hotchk155/pokey-synth/docs/idea.odt

PokeyPig

Introduction

PokeyPig is a MIDI-controlled digital synthesizer based around the Atari CO12294 “POKEY” chip. The POKEY was the sound chip behind Atari home computers in the 1980's and found itself used in a whole bunch or Atari arcade games. POKEY has a distinctive sound – its four channels of warm chimey square wave goodness were often not quite in tune (due to the limitations of the pitch resolution) but nobody cared – it sounded good - and three decades later it still does!

PokeyPig is not the first MIDI synthesizer to use POKEY chips for music, but I hope it is one of the most fun to use. I've tried to make it easy to use while still allowing a whole lot of flexibility so you can keep going deeper with it and probably come up with stuff I never even thought of. The code is also all open-source and based around the popular Arduino toolchain, so you can even get your hands dirty in the firmware coding and tweak it or even rewrite it. Whatever you do with it, I'd love to see it!

The Synth

POKEYpig supports either a single or dual POKEY's.

Each POKEY chip natively supports

- Four square wave voices with 8-bit frequency dividers and digital distortion
- Ability to pair two 8-bit voices into a single channel with 16-bit frequency division (up to two 16 bit voices per POKEY). This can be done to improve the range and the pitch accuracy of the channels.
- Ability to pair two 8-bit voices to provide a single 8 bit voice with digital high-pass filter.
- Master “high” or “low” range for all 8-bit voices on a given POKEY.

PokeyPig gives you access to all the native POKEY chip features, while adding a wealth of functions of its own, such as:

- Amp and Modulation Envelopes
- Low Frequency Oscillator (LFO)
- A flexible modulation matrix
- Pitch Bend
- Portamento
- Polyphonic mode or Unison with Detune and Arpeggiation

Synth configurations (or “tones”) can be saved to EEPROM storage and instantly recalled later.

If you have dual POKEY chips in your PokeyPig you have the additional possibilities of

- Doubling the number of voices available to a Tone, giving you more polyphony or thicker unison sounds.

Or

- Running two tones at the same time, on different MIDI channels (each tone is limited to the voices on a single POKEY chip)

Some Terminology

I even confuse myself with not being consistent in my terminology, so lets set some ground rules now so we know where we stand:

- Lets use the word “tone” to refer to a particular setup of PokeyPig – like a specific type of sound you're getting out of it . For example “crunchy detuned bass sound” or “brassy sound” are “tones”. Tones can be saved to PokeyPigs EEPROM and recalled later.
- Lets use the word “voice” to refer to a single musical note played by PokeyPig. So, to play a chord will requires multiple voices because each voice can only play one note at a time. Typically you'll have two, four or eight voices available depending how many POKEY chips you have and how your tone is configured.
- Lets use the word “channel” to refer to the set of voices that are all assigned to the same tone, allowing polyphony or unison layering. A PokeyPig channel will generally correspond to a given MIDI input channel.
  If you have a single POKEY chip, PokeyPig supports just a single channel, playing a single tone using two or four voices.
  If you have two POKEY chips, you have four or eight voices in a single channel, or you can run two channels side by side, each with two or four voices, each playing different tones (or even the same tone if you like)

Envelopes

Each tone has both an amp and modulation envelope

- The amp envelope controls how the volume of each voice changes over time after a note is played. For example you can change the amp envelope settings to emulate the way an organ note starts immediately as a key is pressed and stops instantly as it is released, or the way a piano note rings and fades slowly after it is struck, or a sax note “swells”
- The modulation envelope works in exactly the same as the amp envelope, but rather than controlling the volume of a note, you can use it to control other properties of the sound of the note, such as pitch or distortion. For example you could have a sound which brings in more nasty distortion the longer the note is held.

Each envelope has an attack and a decay/release control and can operate in one of the following modes

- “Attack-Release” mode is the default. When a key is pressed, the envelope runs up to its highest level at the attack rate, then “sustains” at that highest level until the key is released, at which point it fades out according to the release rate.
- In “Attack-Decay” mode, the level runs up to its highest level at the attack rate but then immediately it fades at the release rate (even if the key is still pressed).
- In “Attack-Retrig” mode, the attack slope will immediately start again when the highest level is reached (if the key remains held). As soon as the key is released the envelope will fade at the release rate.
- In “Retrigger” mode, the envelope will function like “Decay” mode, but as soon as the release slope has finished and the volume has faded out, the attack slope will start again (if the key remains held). As soon as the key is released the envelope will begin the release phase.
- In “Loop” mode, the envelope will operate like “Retrigger” mode but will continue to run over and over even after the key is released. This gives you something like an additional LFO to play with (see later) but note that a keypress is needed to start the envelope, and the wave will jump to the start of the attack slope when a key is pressed.

This does open some interesting possibilities, since every voice has its own envelopes (unlike the channel which has just a single LFO). For example if you have 4 note polyphony you could have 4 of these envelope-based LFOs all running out of phase with each other and wreaking glorious havoc with the sound!

Note that POKEY only supports 15 volume levels per voice (plus silent) so the granularity available to amplitude envelope is rather crude and you may hear “volume stepping” on slow attack/release slopes. Nothing I can do about that – sorry!

While the amp evelope always controls the volume of a voice, the modulation envelope can be used to control all kinds of fun things!

Modulation envelope can be used to control

- Pitch – the pitch rises or falls in accordance with the envelope.
- Distortion – the distortion type changes accordance with the envelope.
- High Pass – the high pass filter frequency changes accordance with the envelope (requires channel with high pass filter capability)
- Detune – The detune amount for unison voices is scaled in accordance with the envelope (requires channel in unison mode with a non-zero detune level)
- LFO Rate – The LFO rate is scaled in accordance with the envelope (channel must be in unison mode)
- LFO Level – The LFO amount is scaled in accordance with the envelope (channel must be in unison mode with a non-zero LFO amount)
- Arpeggiator Rate – The rate of the arpeggiator is scaled in accordance with the envelope (requires unison mode and for the arpeggiator to be active)

The modulation envelope effects

Each of the above has a level control which (depending on the modulation destination) specifies a scaling factor of the

Modulation Sources

Mod Envelope
LFO
Mod Wheel

Modulation Destinations

LFO can be sent to pitch with dedicated intensity control

LFO can be sent to volume with dedicated intensity control

LFO can be sent to modulation matrix with adjustable intensity control

Modulation matrix destinations for LFO are

- Distortion
- High Pass Filter
- Detune
- Arpeggiator Rate

Modulation envelope can be sent to modulation matrix with adjustable intensity control

Modulation matrix destinations for mod envelope are

- Pitch
- Distortion
- High Pass Filter
- Detune
- LFO Rate
- LFO Depth (All?)
- Arpeggiator Rate

Modulation wheel can be sent to modulation matrix

- Distortion
- High Pass Filter
- Detune
- LFO Rate
- LFO Depth (All?)
- Arpeggiator Rate

| LFO | Mod Envelope | Mod Wheel
Amplitude | LFO to Amp intensity | N/A | Mod Matrix Flag
Pitch | LFO to Pitch intensity | Mod Envelope to Mod Matrix Intensity x Mod Matrix Flag | N/A
Distortion | LFO to Mod Matrix intensity x Mod Matrix Flag | Mod Envelope to Mod Matrix Intensity x Mod Matrix Flag | Mod Matrix Flag
High Pass | LFO to Mod Matrix intensity x Mod Matrix Flag | Mod Envelope to Mod Matrix Intensity x Mod Matrix Flag | Mod Matrix Flag
Detune | LFO to Mod Matrix intensity x Mod Matrix Flag | Mod Envelope to Mod Matrix Intensity x Mod Matrix Flag | Mod Matrix Flag
LFO Rate | N/A | Mod Envelope to Mod Matrix Intensity x Mod Matrix Flag | Mod Matrix Flag
LFO Depth | N/A | Mod Envelope to Mod Matrix Intensity x Mod Matrix Flag | Mod Matrix Flag
Arp Rate | LFO to Mod Matrix intensity x Mod Matrix Flag | Mod Envelope to Mod Matrix Intensity x Mod Matrix Flag | Mod Matrix Flag

Low Frequency Oscillator (LFO)

LFO's are common elements of synthesizers – they make repeating wave forms that are used to apply some effect to (or “modulate”) an audio wave form.

Common applications of LFOs are vibrato (making the pitch repeatedly rise and fall slightly) and tremelo (making the volume do much the same).

An LFO is “low frequency” when compared to the audio oscillator that is actually playing a note. While audio is up in the hundreds of Hz (cycles per second), LFO's are most often used in the single Hz figures.

PokeyPig has a single

| Velocity Sensitivity
| Unison
| Transpose
| Fine Tune
| Divider Range
| Arpeggiate
| Arp Rate
| Arp Note Count
| Mod Wheel Dest

Modulation Matrix

The follow table shows the three possible modulation sources and the eight possible modulation destinations.

| Mod Envelope | Mod Wheel | LFO
Volume | No (use amp envelope) | Yes | Yes (scaling of amplitide after amp env etc) “Tremelo”
Pitch | Yes (with control of amount) | No (use pitch bend) | Yes “Vibrato”
Distortion | Yes (scaling of channel Distortion level)
High pass freq | Yes (scaling of channel HPF setting). Only effective if POKEY configured with 8-bit channels with HPF
Detune | Yes (scaling of channel Detune level)
LFO rate | Yes (scaling of channel LFO rate) | | N/A
LFO depth | Yes (scaling of channel LFO depth) | | N/A
Arp Rate | Yes (scaling of channel arp rate)

Tone Management

When you tweak PokeyPig's settings, you are modifying the “active tone”

You can save the tone to PokeyPig's EEPROM, which means it is saved when the power is off.

PokeyPig lets you save 12 tones in memory to be recalled later. Each tone is identified by a note within the octave, so we have tones identified C, C#, D, D# and so on up to B.

A new tones can be loaded using a MIDI program change message with program numbers 0-11

You can also load a tone quickly using a keyboard controller by pressing the mode button on the front of PokeyPig and pressing a note on the controller keyboard, for example press a C key to load the first saved tone (same as program change 0), then release the button.

A similar approach is used to store tones to EEPROM. Changes you make to the active tone are not saved unless you specifically do this. To save a tone, hold down the mode button until the led beside the button starts to blink. Then press the key corresponding to the tone slot you want to save to.

The mode button can also be used to stop any ringing notes (sometimes caused if a MIDI note off message is not received from a controller). Simply quickly press and release the mode button to silence any ringing notes.

If you have two POKEY chips, you can have two tones active on PokeyPig at the same time. You can select “dual tone” mode by pressing two note keys, one after the other, while the mode button is pressed.

The first selected tone is set up on the first POKEY chip and the second tone is set up on the second chip.

14 | Velocity Sensitivity | <=64 OFF >64 ON
120 123 | All sound off
126 | Mono On
127 | Mono Off
124 | Omni Off
125 | Omni On
121 | Reset patch
15 | Unison in poly mode | <=64 OFF >64 ON
16 | Transpose | 64 NONE 0-63 Transpose down by semitones 65-127 Transpose up by semitones
17 | Fine Tune | 64 NONE 0-63 Transpose down by cents 65-127 Transpose up by cents Within capability of POKEY voice!
18 | Pitch Bend Range | 0-127 No pitch bend up to +/-1 octave
5 | Portamento Time | 0-127 0 to 2.5 seconds
20 | High Pass Filter Freq | 0-127 Corresponds to 255 → 0 POKEY setting for HPF divider
21 | Distortion Level | 0-127 Maps to: 0 = No distortion 31 = 4 bit polynomial 52 = 5 bit polynomial 74 = 5/4 bit polynomial 95 = 5/17 bit polynomial 127 = 17 bit polynomial
22 | Unison Type | 0-127 Maps to:
23 | Unison Detune | 0-127 in 10ths of a semitone.
24
25 | LFO depth modulation source
26 | Detune Modulation Source | <=64 OFF >64 ON The mod wheel overrides the HPF controller
27 | High Pass Modulation | <=64 OFF >64 ON The mod wheel overrides the detune level controller
28 | Distortion Modulation | <=64 OFF >64 ON The mod wheel overrides the LFO rate controller
29 | LFO Rate Modulation | <=64 OFF >64 ON The mod wheel overrides the LFO depth controller
30 | Arp Rate Modulation | <=64 OFF >64 ON The mod wheel overrides the arp rate controller
71 | Amp Env Type | 0-127 Maps to: 0 = Attack-Release 38 = Attack-Decay 63= Attack-Repeat-Releasedet 89 = Attack-Decay-Repeat 127 = Attack-Decay-Loop
73 | Amp Env Attack Time | 0-127
72 | Amp Env Release Time | 0-127
75 | From Note
76 | To Note
103 | Mod Env Type | 0-127 Maps to: 0 = Attack-Release 38 = Attack-Decay 63= Attack-Repeat-Release 89 = Attack-Decay-Repeat-Release 127 = Attack-Decay-Loop
104 | Mod Env Attack Time | 0-127
105 | Mod Env Release Time | 0-127
85 | Mod Env Depth To Pitch | 0-127 (-63 to +63)
86 | Mod Env to Distortion | 64 OFF > 64 On < 64 On (inverted) Downscales the channel Distortion setting
87 | Mod Env to High Pass | 64 OFF > 64 On < 64 On (inverted) Downscales the channel Hi Pass setting
88 | Mod Env to Detune | 64 OFF > 64 On < 64 On (inverted) Downscales the channel Detune setting
89 | Mod Env to LFO Rate | 64 OFF > 64 On < 64 On (inverted) Downscales the channel LFO Rate setting
90 | Mod Env to LFO Depth | 64 OFF > 64 On < 64 On (inverted) Downscales the channel LFO Depth setting
91 | Mod Env to Arp Rate | 64 OFF > 64 On < 64 On (inverted) Downscales the channel arp rate setting
92 | Mod Env Depth | -63 0 +63
106 | LFO Mode | 0-127 Maps to: 0 = Don't Run, Hold LFO Value 27 = Free 45= Gated 63 = Free, Reset by Note Trigger 81 = Gated, Reset by Note Trigger 99 = One Shot 127 = Neg-gated (run only when not gated)
107 | LFO Wave | 0-127 Maps to: 0 = Triangle 38 = Ramp 63 = Reverse Ramp 88= Square 114 = Square with random amplitude
108 | LFO Rate
109 | LFO Depth
110 | LFO Depth to Pitch (Vibrato)
111 | LFO Depth to Volume (Tremelo)
112 | LFO to Distortion | 64 OFF > 64 On < 64 On (inverted)
113 | LFO to High Pass | 64 OFF > 64 On < 64 On (inverted)
114 | LFO to Detune | 64 OFF > 64 On < 64 On (inverted)
115 | LFO to Arp Rate | 64 OFF > 64 On < 64 On (inverted)
116 | Arp Enable | <=64 OFF >64 ON
117 | Arp Rate | 0-127
118 | Arp Count | 0-127 Maps to 0-7 max notes in arp sequence
119 | Arp Envelope Trigger | <=64 OFF >64 ON Whether each individual arp note triggers envelopes
93 | POKEY Configuration | 0-127 Maps to: 0 = 8 bit divider (4 channels per chip) 64= 8 bit divider with hi pass (2 channels per chip) 127= 16 bit divider (2 channels per chip)
94 | POKEY divider range | <=64 LOW freq range >64 HIGH freq range Applicable to 8 bit divider modes only
