hotchk155/pokey-synth/docs/test.txt

pb range scale is wrong
freq range setting is lost when changing mode
mod matrix +/- seem reversed
