hotchk155/pokey-synth/docs/test.ods

Sheet: Sheet1
PORTAMENTO |  | y
AMP ENVELOPE |  | Attack | release
 | AttackRelease | y | y
 | AttackDecay | y | y
 | AttackRepeatRelease | y | y
 | AttackDecayRepeat | y | y
 | Loop | y | y
PITCH BEND AND RANGE |  | y
TRANSPOSE |  | y
FINE TUNE |  | y
OMNI
RESET_CONTROLLERS
FROM NOTE |  | y
TO NOTE |  | y
POLY ON |  | y
MONO ON |  | y
DETUNE
 | spread | y
 | interval up | y
 | interval down | y
 | stack up | y
 | stack down | y
 | none
DIST |  | y
HPF |  | y
MOD WHEEL
 | volume | y
 | dist | y
 | hpf | y
 | detune | y
 | lfo rate
 | arp rate
ARPEGGIATOR
MONO

Sheet: Sheet3
0 | 0 | 0
1 | 0.1 | 0.05
2 | 0.2 | 0.1
3 | 0.3 | 0.15
4 | 0.4 | 0.2
5 | 0.5 | 0.25
6 | 0.6 | 0.3
7 | 0.7 | 0.35
8 | 0.8 | 0.4
9 | 0.9 | 0.45
10 | 1 | 0.5
11 | 0.9 | 0.55
12 | 0.8 | 0.6
13 | 0.7 | 0.65
14 | 0.6 | 0.7
15 | 0.5 | 0.75
16 | 0.4 | 0.8
17 | 0.3 | 0.85
18 | 0.2 | 0.9
19 | 0.1 | 0.95
20 | 0 | 1
21 | -0.1 | -0.95
22 | -0.2 | -0.9
23 | -0.3 | -0.85
24 | -0.4 | -0.8
25 | -0.5 | -0.75
26 | -0.6 | -0.7
27 | -0.7 | -0.65
28 | -0.8 | -0.6
29 | -0.9 | -0.55
30 | -1 | -0.5
31 | -0.9 | -0.45
32 | -0.8 | -0.4
33 | -0.7 | -0.35
34 | -0.6 | -0.3
35 | -0.5 | -0.25
36 | -0.4 | -0.2
37 | -0.3 | -0.15
38 | -0.2 | -0.1
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
