hotchk155/pokey-synth/hardware/pokey-synth.brd

## EAGLE design hardware/pokey-synth.brd (2015-09-04)

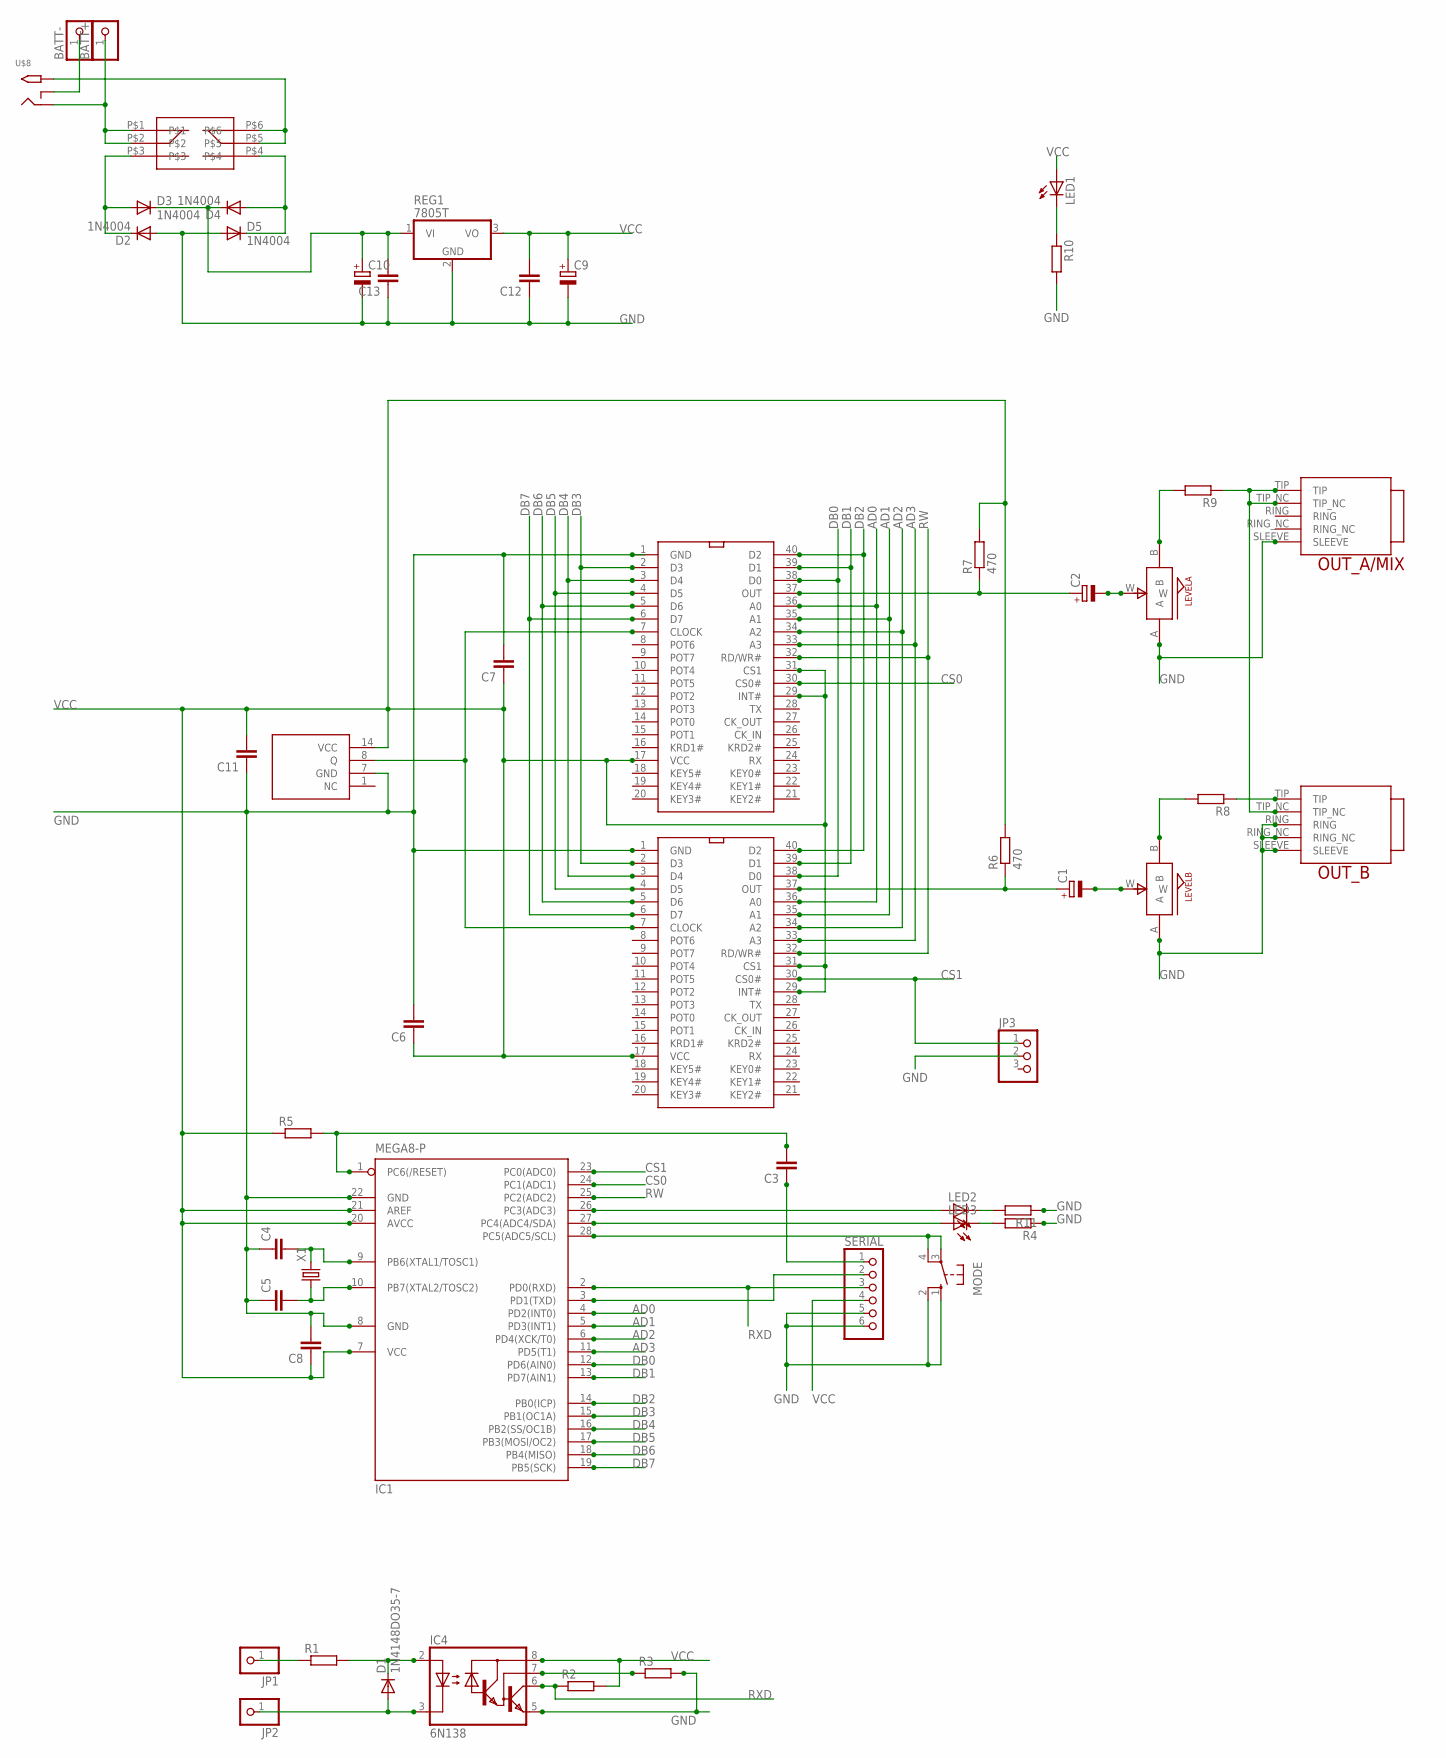
[picture p1: schematic pokey-synth.sch]

Parts:
BATT+: PINHD-1X1; 1X01
BATT-: PINHD-1X1; 1X01
C1, C2, C9, C10: CPOL-EUE2-5; E2-5
C3, C4, C5, C6, C7, C8, C11, C12, C13: C-EU025-024X044; C025-024X044
D1: 1N4148DO35-7; DO35-7
D2, D3, D4, D5: 1N4004; DO-VERT
IC1: MEGA8-P; DIL28-3
IC2, IC3: POKEYDIP40; DIL40
IC4: 6N138; DIL08
JP1, JP2: PINHD-1X1; 1X01
JP3: PINHD-1X3; 1X03
LED1, LED2, LED3: LED3MM
LEVELA: ALPS_POT_SMALL; SMALL_ALPS_POT
LEVELB: ALPS_POT_SMALL; SMALL_ALPS_POT
MODE: 10-XX; B3F-10XX
OSC1: TTLOSC
OUT_A/MIX: TRUCONNECTJACK
OUT_B: TRUCONNECTJACK
R1, R2, R3, R4, R5, R8, R9, R10, R11: R-EU_0207/7; 0207/7
R6, R7: 470; 0207/7
REG1: 7805T; TO220H
SERIAL: HEADER-1X6; 1X06_OVAL
U$8: 2.1MMJACKTHM; PJ-102A
U$9: 2P2T_LATCHING
X1: CRYSTALHC49U-V; HC49U-V

Connections:
AD0: IC1.4 (PD2(INT0)), IC2.36 (A0), IC3.36 (A0)
AD1: IC1.5 (PD3(INT1)), IC2.35 (A1), IC3.35 (A1)
AD2: IC1.6 (PD4(XCK/T0)), IC2.34 (A2), IC3.34 (A2)
AD3: IC1.11 (PD5(T1)), IC2.33 (A3), IC3.33 (A3)
CS0: IC1.24 (PC1(ADC1)), IC2.30 (CS0#)
CS1: IC1.23 (PC0(ADC0)), IC3.30 (CS0#), JP3.1
DB0: IC1.12 (PD6(AIN0)), IC2.38 (D0), IC3.38 (D0)
DB1: IC1.13 (PD7(AIN1)), IC2.39 (D1), IC3.39 (D1)
DB2: IC1.14 (PB0(ICP)), IC2.40 (D2), IC3.40 (D2)
DB3: IC1.15 (PB1(OC1A)), IC2.2 (D3), IC3.2 (D3)
DB4: IC1.16 (PB2(SS/OC1B)), IC2.3 (D4), IC3.3 (D4)
DB5: IC1.17 (PB3(MOSI/OC2)), IC2.4 (D5), IC3.4 (D5)
DB6: IC1.18 (PB4(MISO)), IC2.5 (D6), IC3.5 (D6)
DB7: IC1.19 (PB5(SCK)), IC2.6 (D7), IC3.6 (D7)
GND: C4.1, C5.1, C6.2, C7.2, C8.2, C9.-, C10.-, C11.1, C12.1, C13.1, D2.A, D5.A, IC1.8 (GND), IC1.22 (GND), IC2.1 (GND), IC3.1 (GND), IC4.5 (GND), JP3.2, LEVELA.A, LEVELB.A, MODE.1 (S), MODE.2 (S1), OSC1.7 (GND), OUT_A/MIX.SLEEVE, OUT_B.RING, OUT_B.RING_NC, OUT_B.SLEEVE, R3.2, R4.1, R10.2, R11.1, REG1.2 (GND), SERIAL.5, SERIAL.6
unnamed: C4.2, IC1.9 (PB6(XTAL1/TOSC1)), X1.2
unnamed: C5.2, IC1.10 (PB7(XTAL2/TOSC2)), X1.1
unnamed: C2.-, LEVELA.W
unnamed: LEVELA.B, R9.2
unnamed: OUT_A/MIX.TIP, OUT_A/MIX.TIP_NC, OUT_B.TIP_NC, R9.1
unnamed: C1.-, LEVELB.W
unnamed: JP1.1, R1.1
unnamed: LEVELB.B, R8.2
unnamed: OUT_B.TIP, R8.1
unnamed: IC2.7 (CLOCK), IC3.7 (CLOCK), OSC1.8 (Q)
unnamed: C2.+, IC2.37 (OUT), R7.1
unnamed: C1.+, IC3.37 (OUT), R6.1
unnamed: D1.C, IC4.2 (A), R1.2
unnamed: D1.A, IC4.3 (C), JP2.1
unnamed: BATT+.1, U$8.RING, U$9.P$1, U$9.P$2
unnamed: IC4.7 (VB), R3.1
unnamed: U$8.TIP, U$9.P$5, U$9.P$6
unnamed: C3.2, IC1.1 (PC6(/RESET)), R5.2
unnamed: BATT-.1, U$8.RING_SW
unnamed: C3.1, SERIAL.1
unnamed: D2.C, D3.A, U$9.P$3
unnamed: D4.A, D5.C, U$9.P$4
unnamed: C10.+, C13.2, D3.C, D4.C, REG1.1 (VI)
unnamed: LED1.K (C), R10.1
unnamed: IC1.26 (PC3(ADC3)), LED2.A
unnamed: LED2.K (C), R11.2
unnamed: IC1.28 (PC5(ADC5/SCL)), MODE.3, MODE.4 (P1)
unnamed: IC1.27 (PC4(ADC4/SDA)), LED3.A
unnamed: LED3.K (C), R4.2
RW: IC1.25 (PC2(ADC2)), IC2.32 (RD/WR#), IC3.32 (RD/WR#)
RXD: IC1.2 (PD0(RXD)), IC4.6 (VO), R2.1, SERIAL.3
TXD: IC1.3 (PD1(TXD)), SERIAL.2
VCC: C6.1, C7.1, C8.1, C9.+, C11.2, C12.2, IC1.7 (VCC), IC1.20 (AVCC), IC1.21 (AREF), IC2.17 (VCC), IC2.29 (INT#), IC2.31 (CS1), IC3.17 (VCC), IC3.29 (INT#), IC3.31 (CS1), IC4.8 (VCC), LED1.A, OSC1.14 (VCC), R2.2, R5.1, R6.2, R7.2, REG1.3 (VO), SERIAL.4

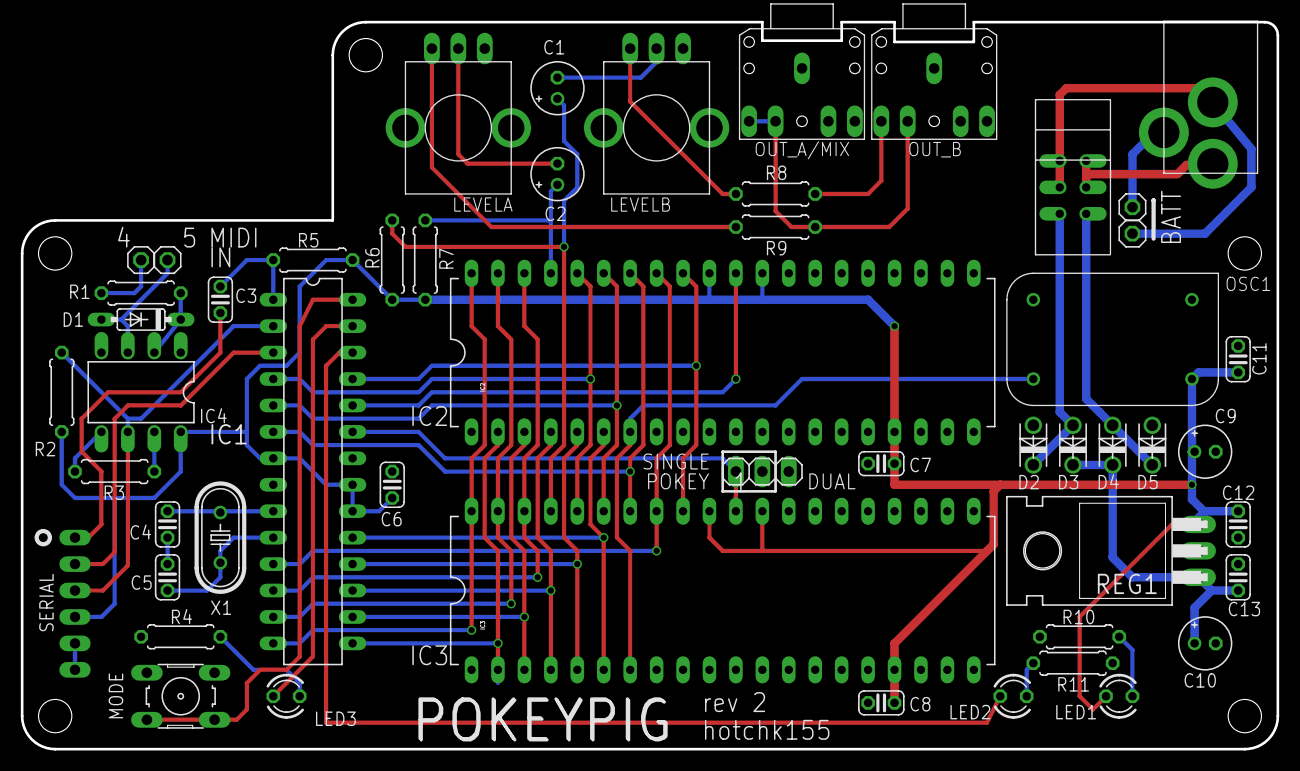
[picture p2: board pokey-synth.brd from above]

Board: 2 copper layers, 120.7 x 69.8 mm, 52 parts (0 on the bottom side), 48 nets.
