hotchk155/pokey-synth/pokey-synth/Pokey.h

///////////////////////////////////////////////////////////
// POKEYPIG
// hotchk155/2015
///////////////////////////////////////////////////////////

///////////////////////////////////////////////////////////
// This class represents a physical POKEY chip which
// has four physical voices (0..3), which can be paired up 
// for 16bit and HPF modes. 
class CPokey { 
  byte m_flags;
  byte m_data[9];    
  void write_reg(byte addr, byte data, byte force = 0);
  void reset_regs();  
  enum {
    FLAG_DIV16    = 0x01,
    FLAG_HPF      = 0x02,
    FLAG_POKEY2   = 0x80,
  };  
public:    
  enum {
    MODE_8BIT = 0,
    MODE_8BITHPF,
    MODE_16BIT
  };
  CPokey(byte which);
  int configure(int mode, byte *voices);
  void pitch(byte voice, float hz);
  void vol(byte voice, float v);
  void quiet(byte voice);
  void dist(byte voice, float v);
  void hpf(byte voice, float v);
  void div8_high(byte voice, byte v);
  void dist_poly9(byte voice, byte v);
  void test();
  
};

// Declare global POKEY objects
extern CPokey Pokey1;
extern CPokey Pokey2;
