hotchk155/pokey-synth/(commit log)

2015-05-29 pcb ready
    [pokey-synth.brd]
2015-06-21 evelopes / trem / vibrato
    [LogicalChannel.cpp, LogicalChannel.h, Pokey.cpp, pokey-synth.ino]
2015-06-26 moving parts
    [ideas.ods]
2015-06-30 more stuff
    [aa.ods, pokey-synth.brd, pokey-synth.sch]
2015-08-30 add jumper
    [pokey-synth.brd, pokey-synth.sch]
2015-09-04 ready for pcb rev2
    [pokey-synth.brd]
2015-09-29 new pcb layout
2015-12-14 current panel
2016-03-14 BOM / single POKEY fascia
